itsjustvenky/WiFiGlcdTempController/Eagle/ESP8266-ILI9341-V003_2.brd

## EAGLE design Eagle/ESP8266-ILI9341-V003_2.brd (2016-01-15)

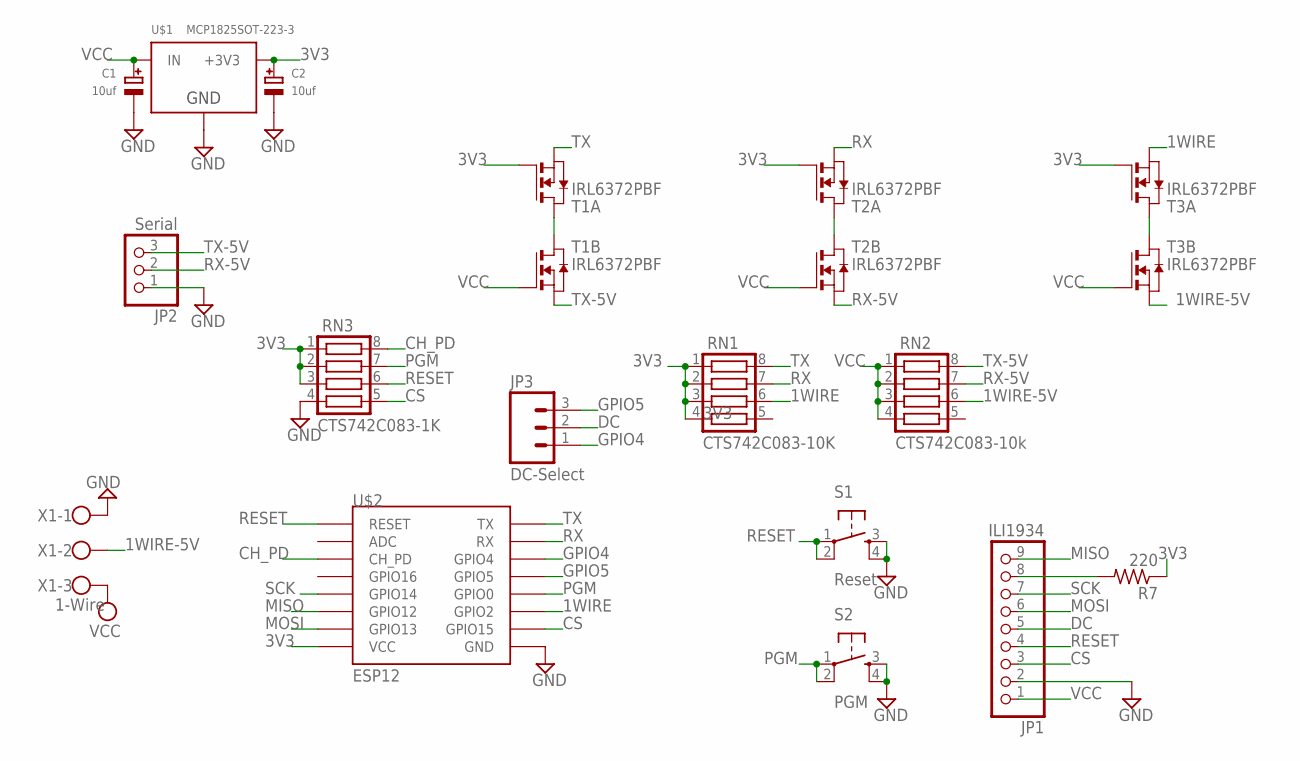
[picture p1: schematic ESP8266-ILI9341-V003_2.sch]

Parts:
C1, C2: 10uf; EIA3216-18/A-R
JP1: ILI1934; 1X09-BIG
JP2: Serial; 1X03
JP3: DC-Select; 1X03
R7: 220; M1206
RN1: CTS742C083-10K; CTS742C083
RN2: CTS742C083-10k; CTS742C083
RN3: CTS742C083-1K; CTS742C083
S1: Reset; TACTILE-PTH
S2: PGM; TACTILE-PTH
T1, T2, T3: IRL6372PBF; SO-8-DUAL
U$1: MCP1825SOT-223-3; SOT-223
U$2: ESP12
X1: 1-Wire; W237-103

Connections:
1WIRE: RN1.6, T3.1 (S), U$2.GPIO2
1WIRE-5V: RN2.6, T3.3 (S), X1.2
3V3: C2.+, R7.1, RN1.1, RN1.2, RN1.3, RN1.4, RN3.1, RN3.2, RN3.3, T1.2 (G), T2.2 (G), T3.2 (G), U$1.3 (+3V3), U$2.VCC
CH_PD: RN3.8, U$2.CH_PD
CS: JP1.3, RN3.5, U$2.GPIO15
DC: JP1.5, JP3.2
GND: C1.-, C2.-, JP1.2, JP2.1, RN3.4, S1.3, S1.4, S2.3, S2.4, U$1.2 (GND), U$2.GND, X1.1
GPIO4: JP3.1, U$2.GPIO4
GPIO5: JP3.3, U$2.GPIO5
MISO: JP1.9, U$2.GPIO12
MOSI: JP1.6, U$2.GPIO13
unnamed: T2.5_6 (D), T2.7_8 (D)
unnamed: T3.5_6 (D), T3.7_8 (D)
unnamed: T1.5_6 (D), T1.7_8 (D)
unnamed: JP1.8, R7.2
PGM: RN3.7, S2.1, S2.2, U$2.GPIO0
RESET: JP1.4, RN3.6, S1.1, S1.2, U$2.RESET
RX: RN1.7, T2.1 (S), U$2.RX
RX-5V: JP2.2, RN2.7, T2.3 (S)
SCK: JP1.7, U$2.GPIO14
TX: RN1.8, T1.1 (S), U$2.TX
TX-5V: JP2.3, RN2.8, T1.3 (S)
VCC: C1.+, JP1.1, RN2.1, RN2.2, RN2.3, RN2.4, T1.4 (G), T2.4 (G), T3.4 (G), U$1.1 (IN), X1.3

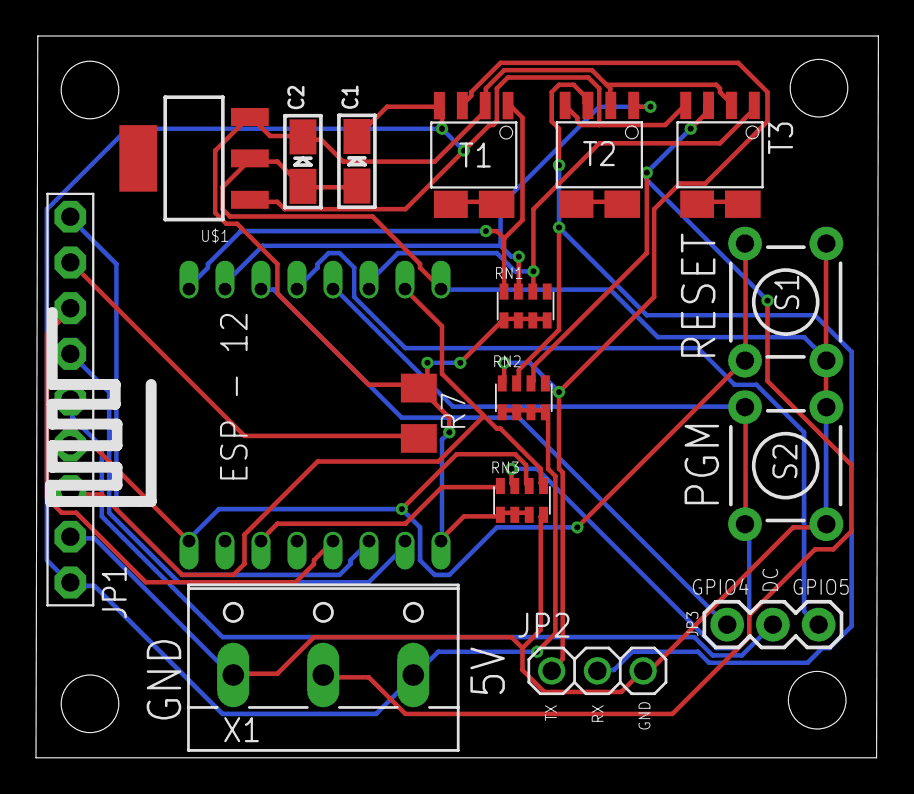
[picture p2: board ESP8266-ILI9341-V003_2.brd from above]

Board: 2 copper layers, 46.8 x 40.1 mm, 17 parts (0 on the bottom side), 23 nets.
