itsjustvenky/WiFiGlcdTempController/WiFiGlcdTempController.ino

/*
WiFiGlcdTempController.ino

Version 0.0.5
Last Modified 11/21/2015
By Jim Mayhugh


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
This software uses multiple libraries that are subject to additional
licenses as defined by the author of that software. It is the user's
and developer's responsibility to determine and adhere to any additional
requirements that may arise.

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
Configuration :
  Enter the ssid and password of your Wifi AP.
  Enter the port number your server is listening on.

*/

#include <ESP8266WiFi.h>
#include <ESP8266mDNS.h>
#include <WiFiUdp.h>
#include <Ticker.h>
#include <OneWire.h>
#include <EEPROM.h>
#include <EEPROMAnything.h>
#include "SPI.h"
#include "Adafruit_GFX.h"
#include "Adafruit_ILI9341.h"
#include <stdio.h>
#include <stdlib.h>
#include <stdint.h>

int status = WL_IDLE_STATUS;
const uint8_t domainCnt = 15;
const uint8_t bonjourCnt = 50;
const uint8_t usemDNS = 0xAA;

const uint16_t udpDebug       = 0x0001;
const uint16_t tempDebug      = 0x0002;
const uint16_t switchDebug    = 0x0004;
const uint16_t lcdDebug       = 0x0008;
const uint16_t eepromDebug    = 0x0010;
const uint16_t findChipsDebug = 0x0020;
const uint16_t mdnsDebug      = 0x0040;
const uint16_t dBugDebug      = 0x0080;
const uint16_t loopDebug      = 0x0100;

uint16_t setDebug = 0x0001;

char packetBuffer[512]; // buffer to hold incoming and outgoing packets
char updateBuffer[128]; // buffer to hold updateStatus
char lcdBuffer[21];

char *versionInfo = (char *)"Version 0.0.5";

int16_t noBytes, packetCnt;
const uint32_t delayVal = 10, sDelayVal = 500, uDelayVal = 60, lcdDelayVal = 2, dBugDelay = 100, cDelayVal = 250;
int16_t lowerC, lowerF, upperC, upperF;
uint32_t lowerDelay, upperDelay, tempDelayStart, tempDelayEnd, startUpperTimer, startLowerTimer;
uint32_t loopStart, loopEnd, loopCnt;
int8_t i;
uint8_t udpAddr[5];
uint8_t data[15];
uint8_t chip[8];
uint8_t chipStatus[3];
// char *delim = (char *)",";
// char *result = NULL;
char mDNSdomain[domainCnt] = "ESP8266";
char bonjourBuf[bonjourCnt] = "";
uint8_t chipCnt = 0;
uint8_t mode = 0xFF, mDNSset;

// EEPROM Storage locations
const uint16_t EEPROMsize   = 4096;
const uint16_t EEMode       = 0x0008; // 'M' = Manual, 'A' = Automatic, anything else = uninitialized
const uint16_t EELowerC     = 0x0010;
const uint16_t EELowerF     = 0x0020;
const uint16_t EEUpperC     = 0x0030;
const uint16_t EEUpperF     = 0x0040;
const uint16_t EEmDNSset    = 0x0050; // 0xAA = set, anything else is uninitialized
const uint16_t EEmDNSdomain = 0x0060; // mDNS domain name
const uint16_t EEWiFiSet    = 0x0080; // 0xAA = set, anything else is unitialized
const uint16_t EEssid       = 0x0090; // WiFi SSID   string
const uint16_t EEpasswd     = 0x00B0; // WiFi PASSWD string
const uint16_t EEuseUDPport = 0x00E0; // 0xAA = set, anything else is uninitialized
const uint16_t EEudpPort    = 0x00F0; // UDP port address
const uint16_t EEs0DelaySet = 0x0100; // 0xAA = set, anything else is uninitialized
const uint16_t EEs0Delay    = 0x0110; // Switch1 Delay
const uint16_t EEs1DelaySet = 0x0120; // 0xAA = set, anything else is uninitialized
const uint16_t EEs1Delay    = 0x0130; // Switch1 Delay
const uint16_t EEipSet      = 0x0140; // 0xAA = set, anything else is uninitialized
const uint16_t EEipAddress  = 0x0150; // static IP Address 
const uint16_t EEipGateway  = 0x0160; // static IP gateway
const uint16_t EEipSubnet   = 0x0170; // static IP subnet

const uint8_t useS0 = 0xAA;
const uint8_t useS1 = 0xAA;
uint8_t s0Set = 0, s1Set = 0;

// WiFi stuff
const uint8_t WiFiStrCnt = 32;  // max string length
const uint8_t ipStrCnt = 20;
const uint8_t useWiFi = 0xAA;
const uint8_t useUDPport = 0xAA;
const uint8_t udpPortCnt = 4;
const uint8_t macCnt = 6;
uint8_t wifiSet = 0, udpSet = 0;
uint8_t macAddress[macCnt] = {0,0,0,0,0,0};
char ssid[WiFiStrCnt]   = "SSID";        // your network SSID (name)
char passwd[WiFiStrCnt] = "PASSWD";      // your network password
char *ipBuf = (char *)"255,255,255,255";
char *gwBuf = (char *)"255,255,255,255";
char *snBuf = (char *)"255,255,255,255";
uint16_t udpPort = 0x0000;                // local port to listen for UDP packets

const uint8_t useStaticIP = 0xAA;
const uint8_t useDHCP = 0x55;
uint8_t staticIPset = 0;
uint8_t ipArray[4] = {0 ,0, 0, 0};
uint8_t gwArray[4] = {0 ,0, 0, 0};
uint8_t snArray[4] = {0 ,0, 0, 0};

/* 
IPAddress staticIP(192, 168, 1, 164);
IPAddress staticGateway(192, 168, 1, 1);
IPAddress staticSubnet(255, 255, 255, 0);
*/

IPAddress staticIP(255,255,255,255);
IPAddress staticGateway(255,255,255,255);
IPAddress staticSubnet(255, 255, 255, 255);

// ILI9341 GLCD -Ticker  lcd; For the ESP8266, these are the default.
#define TFT_DC 4
#define TFT_CS 15
#define ROTATION 3

Adafruit_ILI9341 glcd = Adafruit_ILI9341(TFT_CS, TFT_DC);

// A UDP instance to let us send and receive packets over UDP
WiFiUDP Udp;

// A UDP instance to allow interval updates to be sent
IPAddress statusIP;
uint16_t  statusPort;
WiFiUDP udpStatus;

// OneWire Stuff
// Family codes
const uint8_t t3tcID         = 0xAA; // Teensy 3.0 1-wire slave with MAX31855 K-type Thermocouple chip
const uint8_t dsLCD          = 0x47; // Teensy 3.x 1-wire slave 4x20 HD44780 LCD
const uint8_t dsGLCDP        = 0x45; // Teensy 3.1 1-wire slave 800x400 7" GLCD with Paging
const uint8_t dsGLCD         = 0x44; // Teensy 3.1 1-wire slave 800x400 7" GLCD
const uint8_t max31850ID     = 0x3B; // MAX31850 K-type Thermocouple chip
const uint8_t ds2762ID       = 0x30; // Maxim 2762 digital k-type thermocouple
const uint8_t ds18b20ID      = 0x28; // Maxim DS18B20 digital Thermometer device
const uint8_t ds2406ID       = 0x12; // Maxim DS2406+ digital switch

// DS2406+ Digital Switch Family Code and registers
const uint8_t dsPIO_A        = 0x20;
const uint8_t dsPIO_B        = 0x40;
const uint8_t ds2406MemWr    = 0x55;
const uint8_t ds2406MemRd    = 0xaa;
const uint8_t ds2406AddLow   = 0x07;
const uint8_t ds2406AddHi    = 0x00;
const uint8_t ds2406PIOAoff  = 0x3f;
const uint8_t ds2406PIOAon   = 0x1f;
const uint8_t ds2406End      = 0xff;

const uint8_t switchStatusON   = 'N';
const uint8_t switchStatusOFF  = 'F';

const uint8_t oneWireAddress  =   5; // OneWire Bus Address - use pin GPIO2 for ESP-01 board

const uint8_t chipAddrSize    =   8; // 64bit OneWire Address
const uint8_t tempDataSize    =   9; // temp data
const uint8_t switchDataSize  =  13; // switch data
const uint8_t chipNameSize    =  15;

bool  tempConversion = FALSE;
bool  sendStatus = FALSE;
bool  softReset = FALSE;
bool  udpStatusSet = FALSE;
bool  mdnsUpdateStatus = FALSE;
bool  lcdStatus = FALSE;

// Temp Stuff
typedef struct
{
  uint8_t     tempAddr[chipAddrSize];
  uint8_t     tempData[tempDataSize];
  int16_t     tempFahrenheit;
  int16_t     tempCelsius;
}tempStruct;

const tempStruct tempClear = { {0,0,0,0,0,0,0,0}, {0,0,0,0,0,0,0,0,0}, 0, 0};

tempStruct ds18b20 = { {0,0,0,0,0,0,0,0}, {0,0,0,0,0,0,0,0,0}, 0, 0};

// SwitchStuff
const uint8_t maxSwitches = 2;
const uint8_t upper = 0, lower = 1;

typedef struct
{
  uint8_t     switchAddr[chipAddrSize];
  uint8_t     switchData[switchDataSize];
  char        switchStatus;
  uint32_t    switchDelay;
  bool        switchDelaySet;
}switchStruct;

const switchStruct switchClear = { {0,0,0,0,0,0,0,0}, {0,0,0,0,0,0,0,0,0,0,0,0,0}, 'F', 0, FALSE};

switchStruct ds2406[maxSwitches] =
{
  { {0,0,0,0,0,0,0,0}, {0,0,0,0,0,0,0,0,0,0,0,0,0}, 'F', 0, FALSE},
  { {0,0,0,0,0,0,0,0}, {0,0,0,0,0,0,0,0,0,0,0,0,0}, 'F', 0, FALSE}
};

OneWire ds(oneWireAddress);  // on pin 2 (a 4.7K resistor is necessary)
Ticker  ds18; // timer to allow DS18B20 to be read
Ticker  ds2406_0;
Ticker  ds2406_1;
Ticker  udpUpdate;
Ticker  mdnsServer;
Ticker  lcd;
Ticker  dBug;

// mDNS stuff
// multicast DNS responder
MDNSResponder mdns;
uint16_t mdnsUpdateDelay = 10;
char bonjourNameBuf[25];


void setup(void)
{
  
  ESP.wdtDisable(); // disable the watchdog Timer

  EEPROM.begin(EEPROMsize);
  // Open serial communications and wait for port to open:
  
  Serial.begin(115200);
  delay(sDelayVal);
  glcd.begin();
  glcd.setRotation(ROTATION);
  glcd.fillScreen(ILI9341_BLACK);
  glcd.setTextColor(ILI9341_YELLOW);
  glcd.setTextSize(3);
  glcd.setCursor(0, 0);
  delay(sDelayVal);

  setDebug |= eepromDebug; // display eeprom status during startup
  showEEPROM();
  setDebug &= ~eepromDebug;

  Serial.print("MAC Address = ");
  uint8_t *mac = WiFi.macAddress(macAddress);
  for(uint8_t q = 0; q < macCnt; q++)
  {
    if(mac[q] < 0x10)
      Serial.print("0");
    Serial.print(mac[q], HEX);
    if(q < (macCnt - 1))
      Serial.print(":");
  }
  Serial.println();

  if(wifiSet != useWiFi)
  {
    uint8_t z = 0;
    
    startDebugUpdate();

    for(uint8_t z = 0; z < WiFiStrCnt; z++) // clear ssid and passwd string
    {
      ssid[z]   = 0xFF;
      passwd[z] = 0xFF;
    }

    Serial.print("Enter SSID:");
    while(1)
    {
      while(Serial.available())
      {
        ssid[z] = Serial.read();
        if( (ssid[z] == 0x0A) || (ssid[z] == 0x0D) || (ssid[z] == 0x00) )
        {
          ssid[z] = 0x00;
          break;
        }
        z++;
        if(z == 30)
        {
          ssid[z] = 0x00;
          break;
        }
      }
      if(ssid[z] == 0x00)
        break;
    }
    Serial.println(ssid);

    z = 0;
    Serial.print("Enter PASSWD:");
    while(1)
    {
      while(Serial.available())
      {
        passwd[z] = Serial.read();
        if( (passwd[z] == 0x0A) || (passwd[z] == 0x0D) || (passwd[z] == 0x00) )
        {
          passwd[z] = 0x00;
          break;
        }
        z++;
        if(z == 30)
        {
          passwd[z] = 0x00;
          break;
        }
      }
      if(passwd[z] == 0x00)
        break;
    }
    Serial.println(passwd);
    wifiSet = useWiFi;
    updateEEPROM(EEWiFiSet);
    dBug.detach();
  }

  if( (staticIPset != useStaticIP) && (staticIPset != useDHCP) )
  {
    char c = 0x00;
    Serial.print("Use DHCP?:");
    startDebugUpdate();
    while(1)
    {
      while(Serial.available())
      {
        c = Serial.read();
        break;
      }
      if(c != 0x00)
      {
        Serial.println(c);
        break;
      }
    }

    delay(100);
    while(Serial.available())
      Serial.read(); // flush the buffer
          
    switch(c)
    {
      case 'N':
      case 'n':
      {
        uint8_t z = 0;

        delay(100);
        while(Serial.available())
          Serial.read(); // flush the buffer

        Serial.print("Enter Static IP:");
        while(1)
        {
          while(Serial.available())
          {
            ipBuf[z] = Serial.read();
            if( (ipBuf[z] == 0x0A) || (ipBuf[z] == 0x0D) || (ipBuf[z] == 0x00) )
            {
              ipBuf[z] = 0x00;
              break;
            }
            z++;
            if(z >= ipStrCnt)
            {
              ipBuf[z] = 0x00;
              break;
            } 
          }
          if(ipBuf[z] == 0x00)
            break;
        }
        Serial.println(ipBuf); 
        strToIP(ipArray, ipBuf);
        staticIP[0] = ipArray[0];
        staticIP[1] = ipArray[1];
        staticIP[2] = ipArray[2];
        staticIP[3] = ipArray[3];
        Serial.print("staticIP = ");
        Serial.println(staticIP);

        z = 0;
        
        while(Serial.available())
          Serial.read(); // flush the buffer
          
        Serial.print("Enter Static Gateway:");
        while(1)
        {
          while(Serial.available())
          {
            gwBuf[z] = Serial.read();
            Serial.write(gwBuf[z]);
            if( (gwBuf[z] == 0x0A) || (gwBuf[z] == 0x0D) || (gwBuf[z] == 0x00) )
            {
              Serial.print("gwBuf[");
              Serial.print(z);
              Serial.print("] = 0x");
              Serial.println(gwBuf[z], HEX);
              gwBuf[z] = 0x00;
              Serial.println("EOT");
              break;
            }
            z++;
            if(z >= ipStrCnt)
            {
              Serial.println("String Too Long");
              gwBuf[z] = 0x00;
              break;
            } 
          }
          if(gwBuf[z] == 0x00)
          {
            Serial.println("EOL");
            break;
          }
        }
        Serial.println(gwBuf); 
        strToIP(gwArray, gwBuf);
        staticGateway[0] = gwArray[0];
        staticGateway[1] = gwArray[1];
        staticGateway[2] = gwArray[2];
        staticGateway[3] = gwArray[3];
        Serial.print("staticGateway = ");
        Serial.println(staticGateway);

        z = 0;
        
        while(Serial.available())
          Serial.read(); // flush the buffer
          
        Serial.print("Enter Static subnet:");
        while(1)
        {
          while(Serial.available())
          {
            snBuf[z] = Serial.read();
            if( (snBuf[z] == 0x0A) || (snBuf[z] == 0x0D) || (snBuf[z] == 0x00) )
            {
              snBuf[z] = 0x00;
              break;
            }
            z++;
            if(z >= ipStrCnt)
            {
              snBuf[z] = 0x00;
              break;
            } 
          }
          if(snBuf[z] == 0x00)
            break;
        }
        Serial.println(snBuf); 
        strToIP(snArray, snBuf);
        staticSubnet[0] = snArray[0];
        staticSubnet[1] = snArray[1];
        staticSubnet[2] = snArray[2];
        staticSubnet[3] = snArray[3];
        Serial.print("staticSubnet = ");
        Serial.println(staticSubnet);
        staticIPset = useStaticIP;
        updateEEPROM(EEipSet);
        break;
      }

      case 'Y':
      case 'y':
      default:
      {
        staticIPset = useDHCP;
        updateEEPROM(EEipSet);
        break;
      }
      
    }
    dBug.detach();
  } 
        
  while(Serial.available())
    Serial.read(); // flush the buffer

  if(udpSet != useUDPport)
  {
    uint8_t z = 0;

    for(uint8_t z = 0; z < udpPortCnt; z++) // clear UDP Port Address string
    {
      udpAddr[z]   = 0xFF;
    }

    Serial.print("Enter UDP Port:");
    startDebugUpdate();
    while(1)
    {
      while(Serial.available())
      {
        udpAddr[z] = Serial.read();
        if( (udpAddr[z] == 0x0A) || (udpAddr[z] == 0x0D) || (udpAddr[z] == 0x00) )
        {
          udpAddr[z] = 0x00;
          break;
        }
        z++;
        if(z == 30)
        {
          udpAddr[z] = 0x00;
          break;
        }
      }
      if(udpAddr[z] == 0x00)
        break;
    }
    udpPort = atoi( (char *) udpAddr);
    udpSet = useUDPport;
    Serial.println(udpPort);
    updateEEPROM(EEuseUDPport);
    dBug.detach();
  }

  if(staticIPset == useStaticIP)
  {
    WiFi.config(staticIP, staticGateway, staticSubnet);
    Serial.print("Using Static IP - ");
  }else{
    Serial.print("Using DHCP - ");
  }

  // setting up Station AP
   WiFi.begin(ssid, passwd);
  
  // Wait for connect to AP
  Serial.print("Connecting ");
  Serial.print(ssid);
  int tries=0;

  while (WiFi.status() != WL_CONNECTED)
  {
    startDebugUpdate();
    delay(500);
    yield();
    Serial.print(".");
    tries++;
    if (tries > 30)
    {
      Serial.println();
      Serial.println("Unable to Connect - Check and restart");
      yield();
      glcd.setRotation(ROTATION);
      yield();
      glcd.fillScreen(ILI9341_BLACK);
      yield();
      glcd.setTextColor(ILI9341_YELLOW);
      yield();
      glcd.setTextSize(3);
      yield();
      glcd.setCursor(0, 0);
      yield();
      glcd.println("UNABLE TO CONNECT");
      yield();
      glcd.println("  PLEASE CHECK   ");
      yield();
      glcd.println("   AND RESET     ");
      while(1)
      {
        yield();
      }
    }
    dBug.detach();
  }
  Serial.println();

  IPAddress ip = WiFi.localIP();
  Serial.print("Connected to wifi at IP Address: ");
  Serial.println(ip);

/*
  if(ESP8266Bonjour.begin(bonjourNameBuf))
  {
    Serial.println("Bonjour Service started");
    sprintf(bonjourBuf, "%s._discover", bonjourNameBuf);
    ESP8266Bonjour.addServiceRecord(bonjourBuf, udpPort, MDNSServiceUDP);
//    I2CEEPROM_writeAnything(I2CEEPROMbjAddr, bonjourNameBuf, I2C0x50);
  }else{
    Serial.println(F("Bonjour Service failed"));
  }
  ESP8266Bonjour.run();
*/
  // Set up mDNS responder:
  // - first argument is the domain name, in this example
  //   the fully-qualified domain name is "esp8266.local"
  // - second argument is the IP address to advertise
  //   we send our IP address on the WiFi network


  if(mDNSset != usemDNS)
  {
    sprintf(mDNSdomain, "%s%d", mDNSdomain, ip[3]);
  }  

  if (!mdns.begin(mDNSdomain, WiFi.localIP()))
  {
    Serial.println("Error setting up MDNS responder!");
    while(1) { 
      delay(1000);
    }
  }
  startMDNSupdate();
  Serial.print("mDNS responder started with ");
  Serial.println(mDNSdomain);

  if(setDebug > 0)
  {
    printWifiStatus();
  }

  Serial.print("Udp server started at port at ");
  Serial.println(udpPort);
  Udp.begin(udpPort);
  yield();
  setLcdStatus();
  yield();
  findChips();
  yield();
  scanChips();
  loopCnt = 0;
}

void loop(void)
{
  startDebugUpdate();
  noBytes = Udp.parsePacket();
  loopStart = millis();
  yield();

  if(tempConversion == TRUE)
  {
    if(setDebug & tempDebug)
      Serial.println("tempConversion is TRUE");
    readTemp();
    yield();
    updateState();
    yield();
    scanChips();
    loopCnt = 0;
  }else{
    if(setDebug & tempDebug)
      Serial.println("tempConversion is FALSE");
  }

  yield();
  if(lcdStatus == TRUE)
    updateLCD();

  yield();
  if ( noBytes )
    processUDP();

  yield();
  if ( sendStatus == TRUE )
  {
    statusUpdate();
    sendStatus = FALSE;
  }

  yield();
  if ( mdnsUpdateStatus == TRUE )
    startMDNSupdate();

  delay(10);
  loopEnd = millis();
  if(setDebug & loopDebug)
  {
    Serial.print("loopStart = ");
    Serial.println(loopStart);
    Serial.print("loopEnd = ");
    Serial.println(loopEnd);
    Serial.print("Total loopDelay = ");
    Serial.println(loopEnd - loopStart);
    Serial.print("loopCnt = ");
    Serial.println(loopCnt);
  }
  loopCnt++;
  dBug.detach();
}
