itsjustvenky/WiFiGlcdTempController/processUDP.ino

/*
WiFiGlcdTempController - processUDP.ino

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
This software uses multiple libraries that are subject to additional
licenses as defined by the author of that software. It is the user's
and developer's responsibility to determine and adhere to any additional
requirements that may arise.

THE SOFTWARE IS PROVIDED "AS IS", WITHOUT WARRANTY OF ANY KIND,
EXPRESS OR IMPLIED, INCLUDING BUT NOT LIMITED TO THE WARRANTIES OF
MERCHANTABILITY, FITNESS FOR A PARTICULAR PURPOSE AND
NONINFRINGEMENT. IN NO EVENT SHALL THE AUTHORS OR COPYRIGHT HOLDERS BE
LIABLE FOR ANY CLAIM, DAMAGES OR OTHER LIABILITY, WHETHER IN AN ACTION
OF CONTRACT, TORT OR OTHERWISE, ARISING FROM, OUT OF OR IN CONNECTION
WITH THE SOFTWARE OR THE USE OR OTHER DEALINGS IN THE SOFTWARE.
*/

void processUDP(void)
{
  if(setDebug & udpDebug)
  {
    Serial.print(millis() / 1000);
    Serial.print(":Packet of ");
    Serial.print(noBytes);
    Serial.print(" received from ");
    Serial.print(Udp.remoteIP());
    Serial.print(":");
    Serial.println(Udp.remotePort(), HEX);
  }
  
  // We've received a packet, read the data from it
  Udp.read(packetBuffer, noBytes); // read the packet into the buffer

  // display the packet contents in HEX
  if(setDebug & udpDebug)
  {
    for (int i = 1;i <= noBytes; i++)
    {
      Serial.print(packetBuffer[i-1]);
      if (i % 32 == 0)
      {
        Serial.println();
      }
    } // end for
    Serial.println();
  }

  switch(packetBuffer[0])
  {
    case 'A':
    {
      if(packetBuffer[1] == 'N')
      {
        setState(upper, ds2406PIOAon);
        packetCnt = sprintf(packetBuffer, "%s", "Turning Upper LED ON");
      }else{
        setState(upper, ds2406PIOAoff);
        packetCnt = sprintf(packetBuffer, "%s", "Turning Upper LED OFF");
      }
      break;
    }

    case 'B':
    {
      if(packetBuffer[1] == 'N')
      {
        setState(lower, ds2406PIOAon);
        packetCnt = sprintf(packetBuffer, "%s", "Turning Lower LED ON");
      }else{
        setState(lower, ds2406PIOAoff);
        packetCnt = sprintf(packetBuffer, "%s", "Turning Lower LED OFF");
      }
      break;
    }

    case 'D':
    {
      if(setDebug & udpDebug)
        Serial.print("Setting setDebug to 0x");
      setDebug = atoi(&packetBuffer[1]);
      Serial.println(setDebug, HEX);
      packetCnt = sprintf(packetBuffer, "setDebug = %0X", setDebug);
      break;
    }

    case 'M':
    {
      switch(packetBuffer[1])
      {
        case 'A':
        {
          mode = 'A';
          packetCnt = sprintf(packetBuffer, "Mode is %c - Automatic", mode);
          break;
        }

        case 'M':
        {
          mode = 'M';
          packetCnt = sprintf(packetBuffer, "Mode is %c - Manual", mode);
          break;
        }

        default:
        {
          packetCnt = sprintf(packetBuffer, "Invalid Option - mode is %c", mode);
          break;
        }
      }
      updateEEPROM(EEMode);
      break;
    }

    case 'N':
    {
      uint8_t setDomain = 0, y;

      if((packetBuffer[1] == ' ') && (isalnum(packetBuffer[2])) )
      {
        for(y = 0; y < domainCnt; y++)
        {
          if(isalnum(packetBuffer[y+2]))
          {
            if(setDebug & udpDebug)
              Serial.print(packetBuffer[y+2]);
            continue;
          }else if( ((packetBuffer[y+2] == 0x00) || 
                    (packetBuffer[y+2] == 0x0A) ||
                    (packetBuffer[y+2] == 0x0D)) &&
                    y > 0
                  ){
            if(setDebug & udpDebug)
              Serial.println();
            setDomain = 1;
            break;
          }
        }

        if(setDomain == 1)
        {
          mDNSset = usemDNS;
          for(y = 0; y < domainCnt; y++) // clear domain name buffer
            mDNSdomain[y] = 0;
          for(y = 0; y < domainCnt; y++)
          {
            if(isalnum(packetBuffer[y+2])) // move domain name to domain buffer
              mDNSdomain[y] = packetBuffer[y+2];
          }
          updateEEPROM(EEmDNSset);
          softReset = TRUE;
        }
      }
      packetCnt = sprintf(packetBuffer, "mDNSdomain = %s", mDNSdomain);
      break;
    }

    case 'R':
    {
      if(udpStatusSet == TRUE)
      {
        udpUpdate.detach();
        udpStatus.stop();
      }
      statusIP = Udp.remoteIP();
      statusPort = Udp.remotePort();
//      statusPort = atoi(&packetBuffer[1]);
      udpStatus.begin(statusPort);
      startUdpStatusUpdate();
      packetCnt = sprintf(packetBuffer, "udpStatusUpdate begun at IP %d.%d.%d.%d, port %d", statusIP[0], statusIP[1], statusIP[2], statusIP[3], statusPort);
      udpStatusSet = TRUE;
      break;
    }

/*
  Process: Sets the appropriate temp value and delay for automatic temperature control
  Format:  S,LOC,TYPE,TEMP,DELAY
  Where:
    S     = The UDP command 'S'
    LOC   = The First 'U' or second 'L' switch
    TYPE  = Either Celsius 'C' or Fahrenheit 'F'
    TEMP  = The Temperature in integer degrees, ie "100"
    DELAY = The Delay before activating the switch in seconds, ie "10"
*/
    case 'S':
    {
      char *pos = strchr(packetBuffer, ',');
      char switchLOC   = (char) *(pos+1);
      pos = strchr(pos+1, ',');
      char switchTYPE  = (char) *(pos+1);
      pos = strchr(pos+1, ',');
      char *pos1 = strchr(pos+1, ',');
      *pos1 = 0x00;
      char *switchTEMP  = pos+1;
      char *switchDELAY = pos1+1;

      if(setDebug & udpDebug)
      {
        Serial.print("switchLOC = ");
        Serial.println(switchLOC);
        Serial.print("switchTYPE = ");
        Serial.println(switchTYPE);
        Serial.print("switchTEMP = ");
        Serial.println(switchTEMP);
        Serial.print("switchDELAY = ");
        Serial.println(switchDELAY);
      }
      
      uint8_t   useUpper  = 0, useLower = 0, sError = 0;
      int16_t   useTemp   = atoi(switchTEMP);
      uint16_t  useDelay  = atoi(switchDELAY);
      
      switch(switchLOC)
      {
        case 'U':
        {
          useUpper = 1;
          ds2406[upper].switchDelay = useDelay;
          s0Set = useS0;
          updateEEPROM(EEs0Delay);
          break;
        }

        case 'L':
        {
          useLower = 1;
          ds2406[lower].switchDelay = useDelay;
          s1Set = useS1;
          updateEEPROM(EEs1Delay);
          break;
        }

        default:
        {
          sError = 1;
          break;
        }
      }
      
      switch(switchTYPE)
      {
        
        case 'C':
        {
          if(useLower == 1)
          {
            lowerC = useTemp;
            lowerF = (((useTemp * 9) / 5) + 32);
            updateEEPROM(EELowerC);
          }else if(useUpper == 1)
          {
            upperC = useTemp;
            upperF = (((useTemp * 9) / 5) + 32);
            updateEEPROM(EEUpperC);
          }else{
            sError = 1;
          }
          break;
        }

        case 'F':
        {
          if(useLower == 1)
          {
            lowerF = useTemp;
            lowerC = (((useTemp - 32) * 5) / 9); 
            updateEEPROM(EELowerF);
          }else if(useUpper == 1)
          {
            upperF = useTemp;
            upperC = (((useTemp - 32) * 5) / 9); 
            updateEEPROM(EEUpperF);
          }else{
            sError = 1;
          }
          break;
        }
        
        default:
        {
          sError = 1;
          break;
        }
      }

      if(sError == 0)
      {
        packetCnt = sprintf(packetBuffer, "Upper is %d F, %d C, %d Sec, Lower is %d F, %d C, %d Sec",
                            upperF, upperC, ds2406[upper].switchDelay,
                            lowerF, lowerC, ds2406[lower].switchDelay
                            );
      }else{
        packetCnt = sprintf(packetBuffer, "Invalid Option - Upper value is %d F, %d C, %d Sec, Lower is %d F, %d C, %d Sec",
                            upperF, upperC, ds2406[upper].switchDelay,
                            lowerF, lowerC, ds2406[lower].switchDelay
                            );

      }
      break;
    }

    case 'V':
    {
      packetCnt = sprintf(packetBuffer, "%d, %d, %d, %d, %d, %d", 
                          upperF, upperC, ds2406[upper].switchDelay,
                          lowerF, lowerC, ds2406[lower].switchDelay
                         );
      break;
    }
    
    default:
    {
      packetCnt = sprintf(packetBuffer, "%d, %d, %c, %c, %s", ds18b20.tempCelsius, ds18b20.tempFahrenheit,
                                                          ds2406[upper].switchStatus, ds2406[lower].switchStatus, mDNSdomain);
      break;
    }
  }

  if(setDebug & udpDebug)
    Serial.println(packetBuffer);
  Udp.beginPacket(Udp.remoteIP(), Udp.remotePort());
  Udp.write(packetBuffer, packetCnt);
  Udp.endPacket();
}
