itsjustvenky/WiFiGlcdTempController/showEEPROM.ino

/*
WiFiGlcdTempController - showEEPROM.ino

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
This software uses multiple libraries that are subject to additional
licenses as defined by the author of that software. It is the user's
and developer's responsibility to determine and adhere to any additional
requirements that may arise.

THE SOFTWARE IS PROVIDED "AS IS", WITHOUT WARRANTY OF ANY KIND,
EXPRESS OR IMPLIED, INCLUDING BUT NOT LIMITED TO THE WARRANTIES OF
MERCHANTABILITY, FITNESS FOR A PARTICULAR PURPOSE AND
NONINFRINGEMENT. IN NO EVENT SHALL THE AUTHORS OR COPYRIGHT HOLDERS BE
LIABLE FOR ANY CLAIM, DAMAGES OR OTHER LIABILITY, WHETHER IN AN ACTION
OF CONTRACT, TORT OR OTHERWISE, ARISING FROM, OUT OF OR IN CONNECTION
WITH THE SOFTWARE OR THE USE OR OTHER DEALINGS IN THE SOFTWARE.
*/

void showEEPROM(void)
{
  EEPROM_readAnything(EELowerC, lowerC);
  EEPROM_readAnything(EELowerF, lowerF);
  EEPROM_readAnything(EEUpperC, upperC);
  EEPROM_readAnything(EEUpperF, upperF);
  EEPROM_readAnything(EEMode, mode);
  EEPROM_readAnything(EEmDNSset, mDNSset);
  EEPROM_readAnything(EEipSet, staticIPset);
  if(staticIPset == useStaticIP)
  {
    EEPROM_readAnything(EEipAddress, staticIP);
    EEPROM_readAnything(EEipGateway, staticGateway);
    EEPROM_readAnything(EEipSubnet, staticSubnet);
  }
  if(mDNSset == usemDNS)  
    EEPROM_readAnything(EEmDNSdomain, mDNSdomain);
  EEPROM_readAnything(EEWiFiSet, wifiSet);
  if(wifiSet == useWiFi)
  {
    EEPROM_readAnything(EEssid, ssid);
    EEPROM_readAnything(EEpasswd, passwd);
  }
  EEPROM_readAnything(EEuseUDPport, udpSet);
  if(udpSet == useUDPport)
  {
    EEPROM_readAnything(EEudpPort, udpPort);
  }  
  EEPROM_readAnything(EEs0DelaySet, s0Set);
  if(s0Set == useS0)
  {
    EEPROM_readAnything(EEs0Delay, ds2406[0].switchDelay);
  }  
  EEPROM_readAnything(EEs1DelaySet, s1Set);
  if(s1Set == useS1)
  {
    EEPROM_readAnything(EEs1Delay, ds2406[1].switchDelay);
  }  

  if(setDebug & eepromDebug)
  {
    Serial.print("lowerC = ");
    Serial.print(lowerC);
    Serial.print(", lowerF = ");
    Serial.print(lowerF);
    Serial.print(", upperC = ");
    Serial.print(upperC);
    Serial.print(", upperF = ");
    Serial.println(upperF);
    Serial.print("ds2406[0].switchDelay = ");
    Serial.print(ds2406[0].switchDelay);
    Serial.print(", ds2406[1].switchDelay = ");
    Serial.println(ds2406[1].switchDelay);
    Serial.print("mode = ");
  
    switch(mode)
    {
      case 'A':
      {
        Serial.print("Automatic");      
        break;
      }
      
      case 'M':
      {
        Serial.print("Manual");      
        break;
      }
      
      default:
      {
        Serial.print("Uninitialized");      
        break;
      }
    }
    Serial.println();
    delay(100);
    Serial.print("mDNSdomain = ");
    Serial.println(mDNSdomain);
    delay(100);
    Serial.print("ssid = ");
    Serial.println(ssid);
    delay(100);
    Serial.print("passwd = ");
    Serial.println(passwd);
    delay(100);
    Serial.print("staticIP = ");
    Serial.println(staticIP);
    delay(100);
    Serial.print("staticGateway = ");
    Serial.println(staticGateway);
    delay(100);
    Serial.print("staticSubnet = ");
    Serial.println(staticSubnet);
    delay(100);
    Serial.print("udpPort = ");
    Serial.println(udpPort);
  }

}

void updateEEPROM(uint16_t level)
{
  switch(level)
  {
    case EELowerC:
    case EELowerF:
    {
      EEPROM_writeAnything(EELowerC, lowerC);
      EEPROM_writeAnything(EELowerF, lowerF);
      break;
    }
    
    case EEUpperC:
    case EEUpperF:
    {
      EEPROM_writeAnything(EEUpperC, upperC);
      EEPROM_writeAnything(EEUpperF, upperF);
      break;
    }
    
    case EEMode:
    {
      EEPROM_writeAnything(EEMode, mode);
      break;
    }

    case EEmDNSset:
    {
      EEPROM_writeAnything(EEmDNSset, mDNSset);
      EEPROM_writeAnything(EEmDNSdomain, mDNSdomain);
      break;
    }

    case EEWiFiSet:
    {
      EEPROM_writeAnything(EEWiFiSet, wifiSet);
      EEPROM_writeAnything(EEssid, ssid);
      EEPROM_writeAnything(EEpasswd, passwd);
      break;
    }

    case EEipSet:
    {
      EEPROM_writeAnything(EEipSet, staticIPset);
      for(uint8_t x = 0; x < 4; x++)
      {
        EEPROM_writeAnything(EEipAddress, staticIP);
        EEPROM_writeAnything(EEipGateway, staticGateway);
        EEPROM_writeAnything(EEipSubnet, staticSubnet);
      }
      break;
    }

    case EEuseUDPport:
    {
      EEPROM_writeAnything(EEuseUDPport, udpSet);
      EEPROM_writeAnything(EEudpPort, udpPort);
      break;
    }

    case EEs0Delay:
    {
      EEPROM_writeAnything(EEs0DelaySet, s0Set);
      EEPROM_writeAnything(EEs0Delay, ds2406[0].switchDelay);
      break;
    }

    case EEs1Delay:
    {
      EEPROM_writeAnything(EEs1DelaySet, s1Set);
      EEPROM_writeAnything(EEs1Delay, ds2406[1].switchDelay);
      break;
    }
  }
  EEPROM.commit();
  showEEPROM();
}
